DrachmaMfg/Diode-Ladder-VCF/VCF/Tayda Quick Order.csv

sku | qty
A-2281 | 10
A-2200 | 10
A-2307 | 10
A-2772 | 10
A-2290 | 10
A-2279 | 10
A-2248 | 10
A-2630 | 10
A-1531 | 5
A-4008 | 10
A-3290 | 2
A-4534 | 2
A-157 | 12
A-1138 | 2
A-2563 | 4
A-5591 | 5
A-5292 | 1
A-5776 | 1
A-1303 | 1
A-1305 | 1
A-2810 | 5
A-5582 | 1
A-2939 | 1
