DrachmaMfg/Diode-Ladder-VCF/VCF/Schematic.pdf

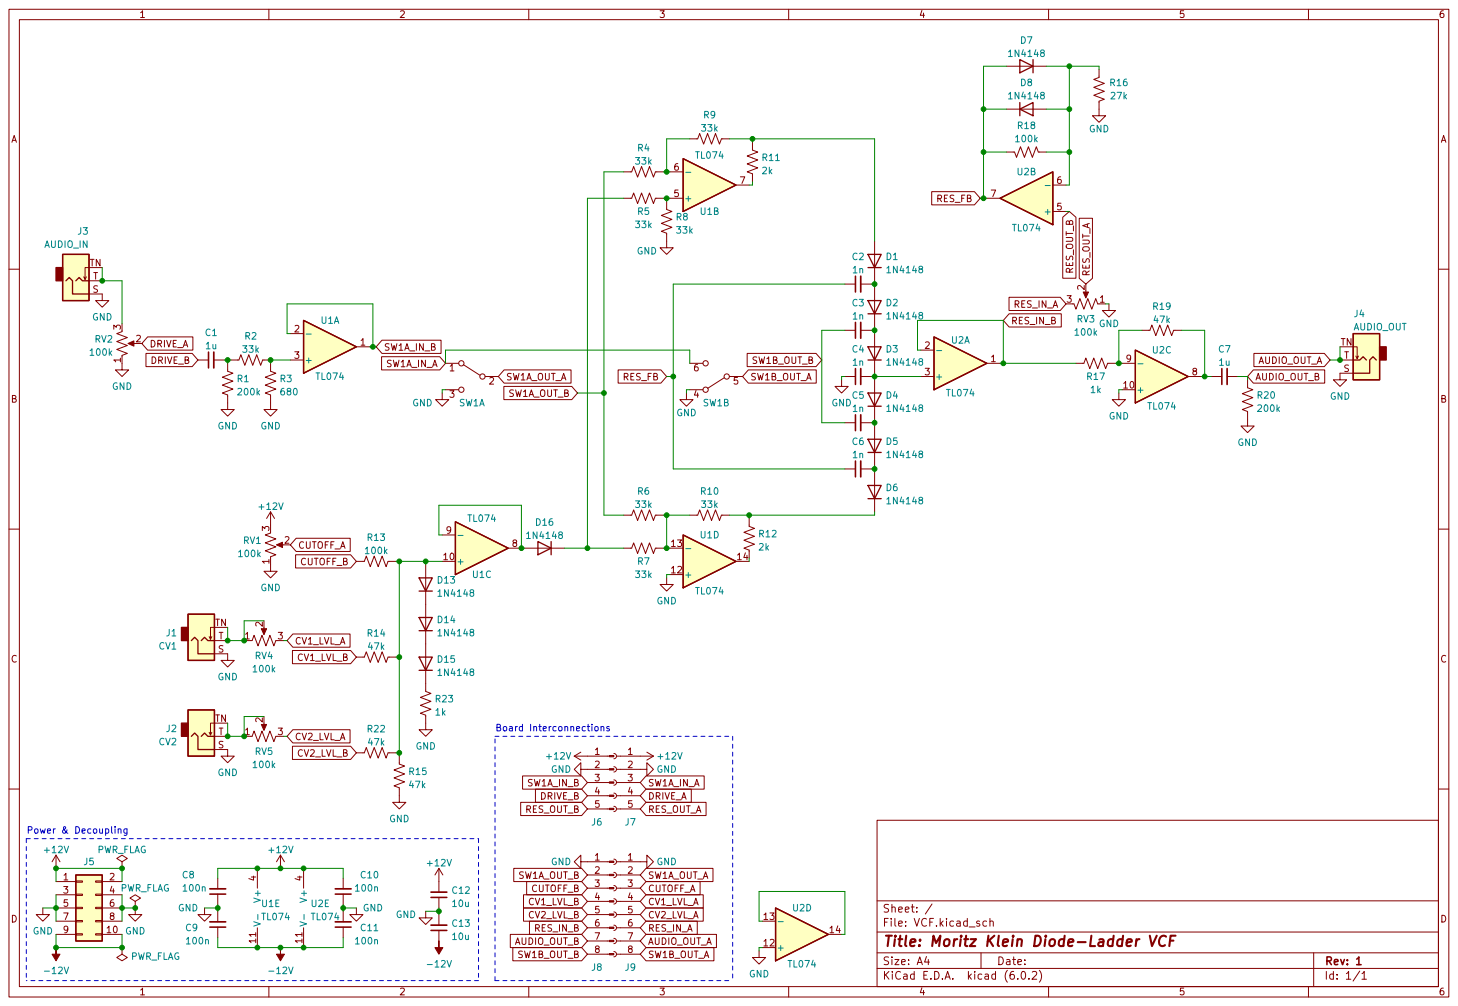
[picture p1: page 1]

File: VCF.kicad_sch Sheet: /
Id: 1/1 Title: Moritz Klein Diode-Ladder VCF
