DrachmaMfg/Diode-Ladder-VCF/VCF/KiCad Files/VCF.kicad_pcb

## KiCad design VCF/KiCad Files/VCF.kicad_pcb (2023-01-26)

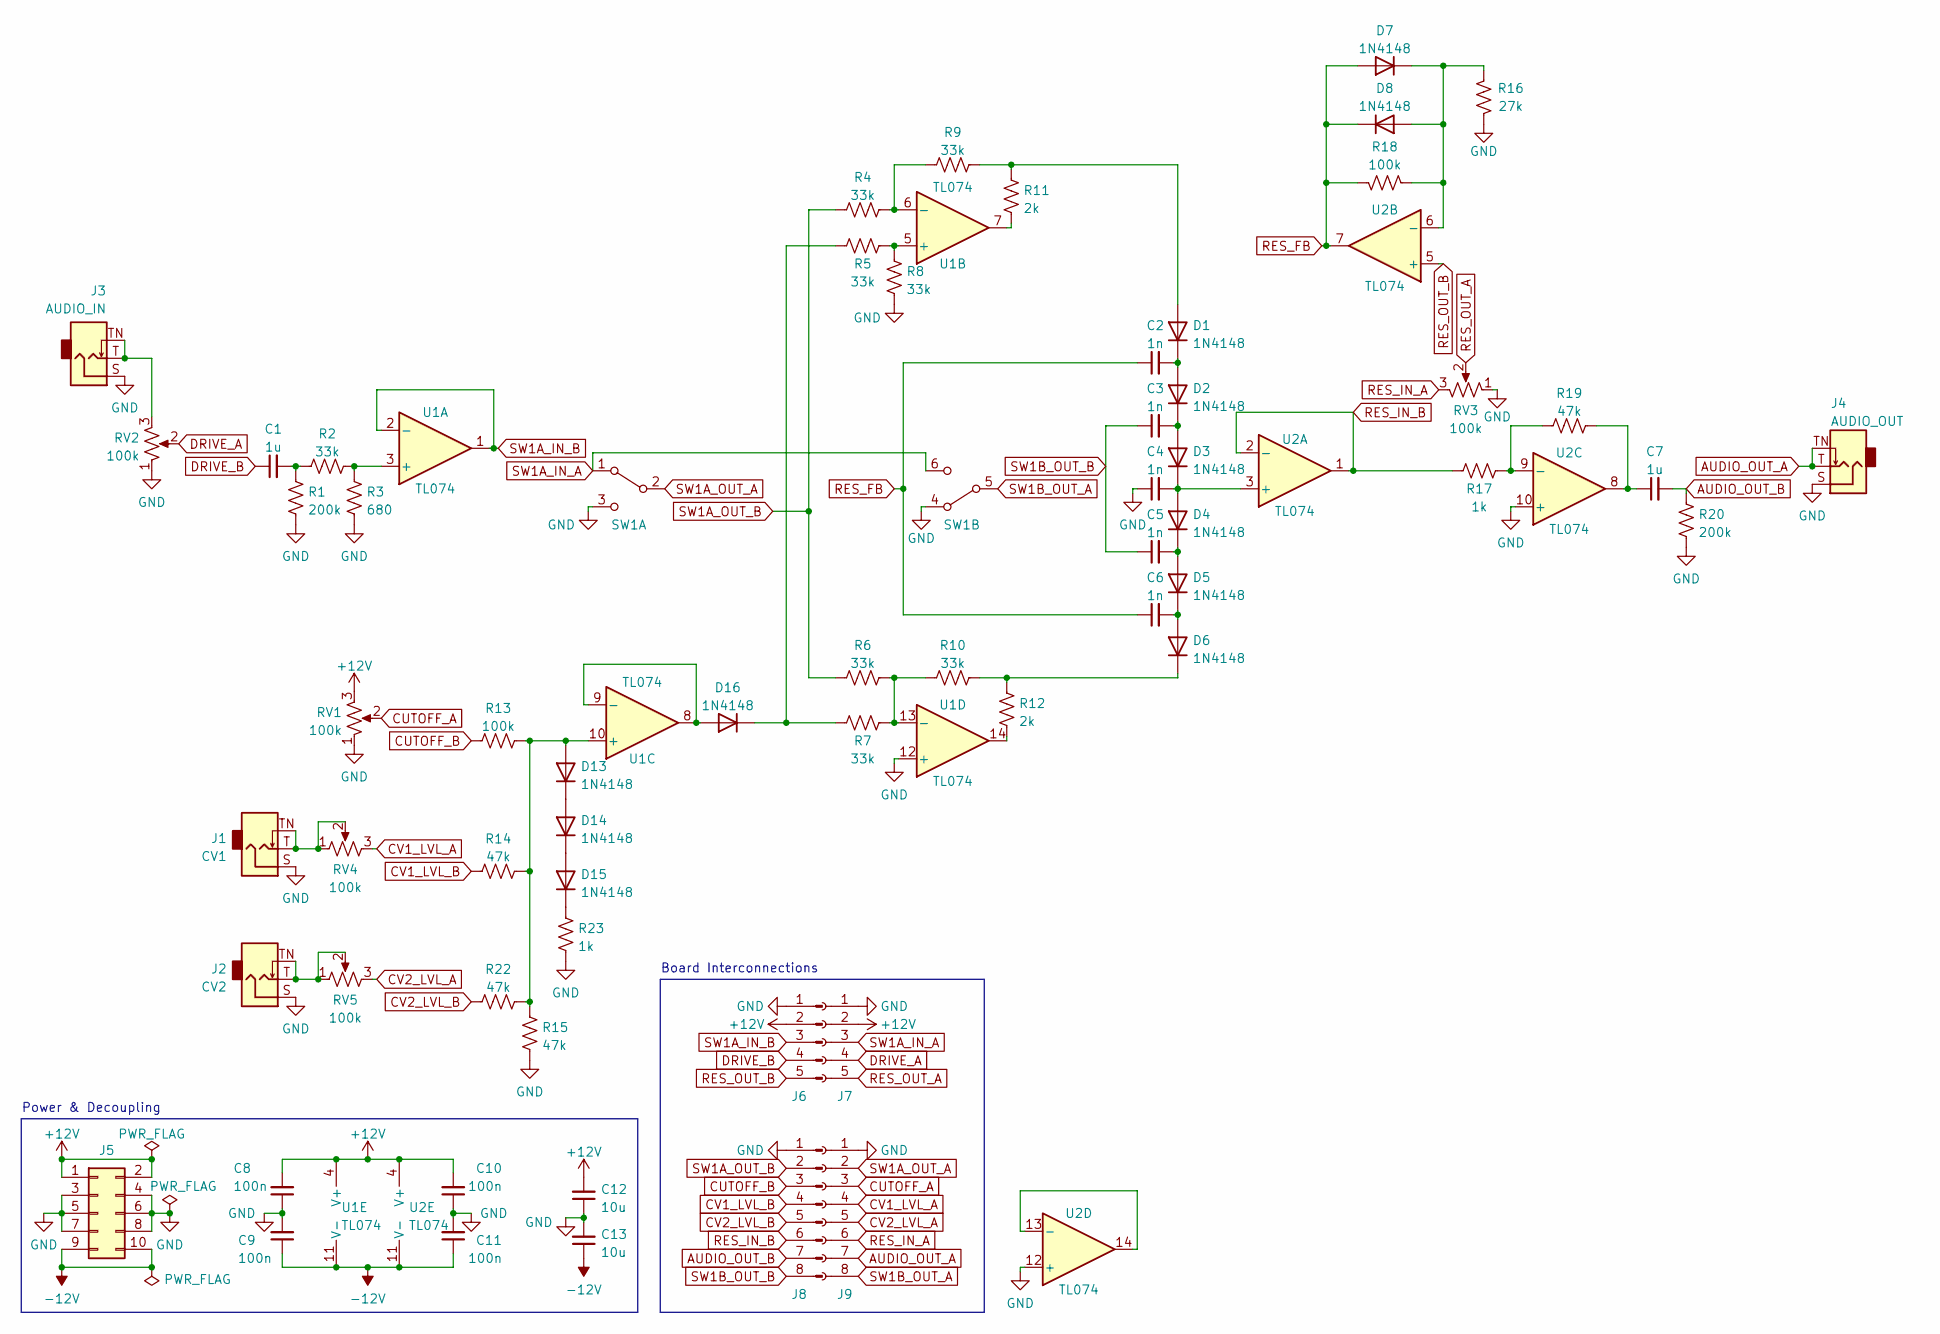
[picture p2: schematic VCF.kicad_sch, Moritz Klein Diode-Ladder VCF]

Parts:
C1, C7: 1u; C_Rect_L7.2mm_W3.5mm_P5.00mm_FKS2_FKP2_MKS2_MKP2
C2, C3, C4, C5, C6: 1n; C_Rect_L7.2mm_W2.5mm_P5.00mm_FKS2_FKP2_MKS2_MKP2
C8, C9, C10, C11: 100n; C_Disc_D3.8mm_W2.6mm_P2.50mm
C12, C13: 10u; CP_Radial_D5.0mm_P2.00mm
D1, D2, D3, D4, D5, D6, D7, D8, D13, D14, D15, D16: 1N4148; D_DO-35_SOD27_P7.62mm_Horizontal
J1: CV1; Jack_3.5mm_QingPu_WQP-PJ398SM_Vertical_CircularHoles_Compact
J2: CV2; Jack_3.5mm_QingPu_WQP-PJ398SM_Vertical_CircularHoles_Compact
J3: AUDIO_IN; Jack_3.5mm_QingPu_WQP-PJ398SM_Vertical_CircularHoles_Compact
J4: AUDIO_OUT; Jack_3.5mm_QingPu_WQP-PJ398SM_Vertical_CircularHoles_Compact
J5: Conn_02x05_Odd_Even; PinHeader_2x05_P2.54mm_Vertical
J6: Conn_01x05_Male; PinHeader_1x05_P2.54mm_Vertical
J7: Conn_01x05_Female; PinSocket_1x05_P2.54mm_Vertical
J8: Conn_01x08_Male; PinHeader_1x08_P2.54mm_Vertical
J9: Conn_01x08_Female; PinSocket_1x08_P2.54mm_Vertical
R1, R20: 200k; R_Axial_DIN0207_L6.3mm_D2.5mm_P7.62mm_Horizontal
R2, R4, R5, R6, R7, R8, R9, R10: 33k; R_Axial_DIN0207_L6.3mm_D2.5mm_P7.62mm_Horizontal
R3: 680; R_Axial_DIN0207_L6.3mm_D2.5mm_P7.62mm_Horizontal
R11, R12: 2k; R_Axial_DIN0207_L6.3mm_D2.5mm_P7.62mm_Horizontal
R13, R18: 100k; R_Axial_DIN0207_L6.3mm_D2.5mm_P7.62mm_Horizontal
R14, R15, R19, R22: 47k; R_Axial_DIN0207_L6.3mm_D2.5mm_P7.62mm_Horizontal
R16: 27k; R_Axial_DIN0207_L6.3mm_D2.5mm_P7.62mm_Horizontal
R17, R23: 1k; R_Axial_DIN0207_L6.3mm_D2.5mm_P7.62mm_Horizontal
RV1, RV2, RV3, RV4, RV5: 100k; Potentiometer_Alpha_Metal
SW1: SW_DPDT_x2; SW_DPDT_2MD1T2B1M1QES
U1, U2: TL074; DIP-14_W7.62mm

Connections:
+12V: C8.2, C10.2, C12.2, J5.1, J5.2, J6.2, J7.2, RV1.3, U1.4 (V+), U2.4 (V+)
-12V: C9.1, C11.1, C13.1, J5.9, J5.10, U1.11 (V-), U2.11 (V-)
AUDIO_OUT_A: J4.T, J4.TN, J9.7
AUDIO_OUT_B: C7.2, J8.7, R20.2
CUTOFF_A: J9.3, RV1.2
CUTOFF_B: J8.3, R13.1
CV1_LVL_A: J9.4, RV4.3
CV1_LVL_B: J8.4, R14.1
CV2_LVL_A: J9.5, RV5.3
CV2_LVL_B: J8.5, R22.1
DRIVE_A: J7.4, RV2.2
DRIVE_B: C1.1, J6.4
GND: C4.1, C8.1, C9.2, C10.1, C11.2, C12.1, C13.2, J1.S, J2.S, J3.S, J4.S, J5.3, J5.4, J5.5, J5.6, J5.7, J5.8, J6.1, J7.1, J8.1, J9.1, R1.1, R3.1, R8.1, R15.1, R16.1, R20.1, R23.1, RV1.1, RV2.1, RV3.1, SW1.3 (C), SW1.4 (A), U1.12 (+), U2.10 (+), U2.12 (+)
unnamed: C1.2, R1.2, R2.1
unnamed: C2.2, D1.1 (K), D2.2 (A)
unnamed: C3.2, D2.1 (K), D3.2 (A)
unnamed: C4.2, D3.1 (K), D4.2 (A), U2.3 (+)
unnamed: C5.2, D4.1 (K), D5.2 (A)
unnamed: C6.2, D5.1 (K), D6.2 (A)
unnamed: C7.1, R19.2, U2.8
unnamed: D1.2 (A), R9.2, R11.2
unnamed: D6.1 (K), R10.2, R12.2
unnamed: D7.1 (K), D8.2 (A), R16.2, R18.1, U2.6 (-)
unnamed: D13.1 (K), D14.2 (A)
unnamed: D13.2 (A), R13.2, R14.2, R15.2, R22.2, U1.10 (+)
unnamed: D14.1 (K), D15.2 (A)
unnamed: D15.1 (K), R23.2
unnamed: D16.1 (K), R5.1, R7.1
unnamed: D16.2 (A), U1.8, U1.9 (-)
unnamed: J1.T, J1.TN, RV4.1, RV4.2
unnamed: J2.T, J2.TN, RV5.1, RV5.2
unnamed: J3.T, J3.TN, RV2.3
unnamed: R2.2, R3.2, U1.3 (+)
unnamed: R4.2, R9.1, U1.6 (-)
unnamed: R5.2, R8.2, U1.5 (+)
unnamed: R6.2, R7.2, R10.1, U1.13 (-)
unnamed: R11.1, U1.7
unnamed: R12.1, U1.14
unnamed: R17.2, R19.1, U2.9 (-)
unnamed: U2.13 (-), U2.14
RES_FB: C2.1, C6.1, D7.2 (A), D8.1 (K), R18.2, U2.7
RES_IN_A: J9.6, RV3.3
RES_IN_B: J8.6, R17.1, U2.1, U2.2 (-)
RES_OUT_A: J7.5, RV3.2
RES_OUT_B: J6.5, U2.5 (+)
SW1A_IN_A: J7.3, SW1.1 (A), SW1.6 (C)
SW1A_IN_B: J6.3, U1.1, U1.2 (-)
SW1A_OUT_A: J9.2, SW1.2 (B)
SW1A_OUT_B: J8.2, R4.1, R6.1
SW1B_OUT_A: J9.8, SW1.5 (B)
SW1B_OUT_B: C3.1, C5.1, J8.8

Notes on the sheet:
Board Interconnections
Power & Decoupling

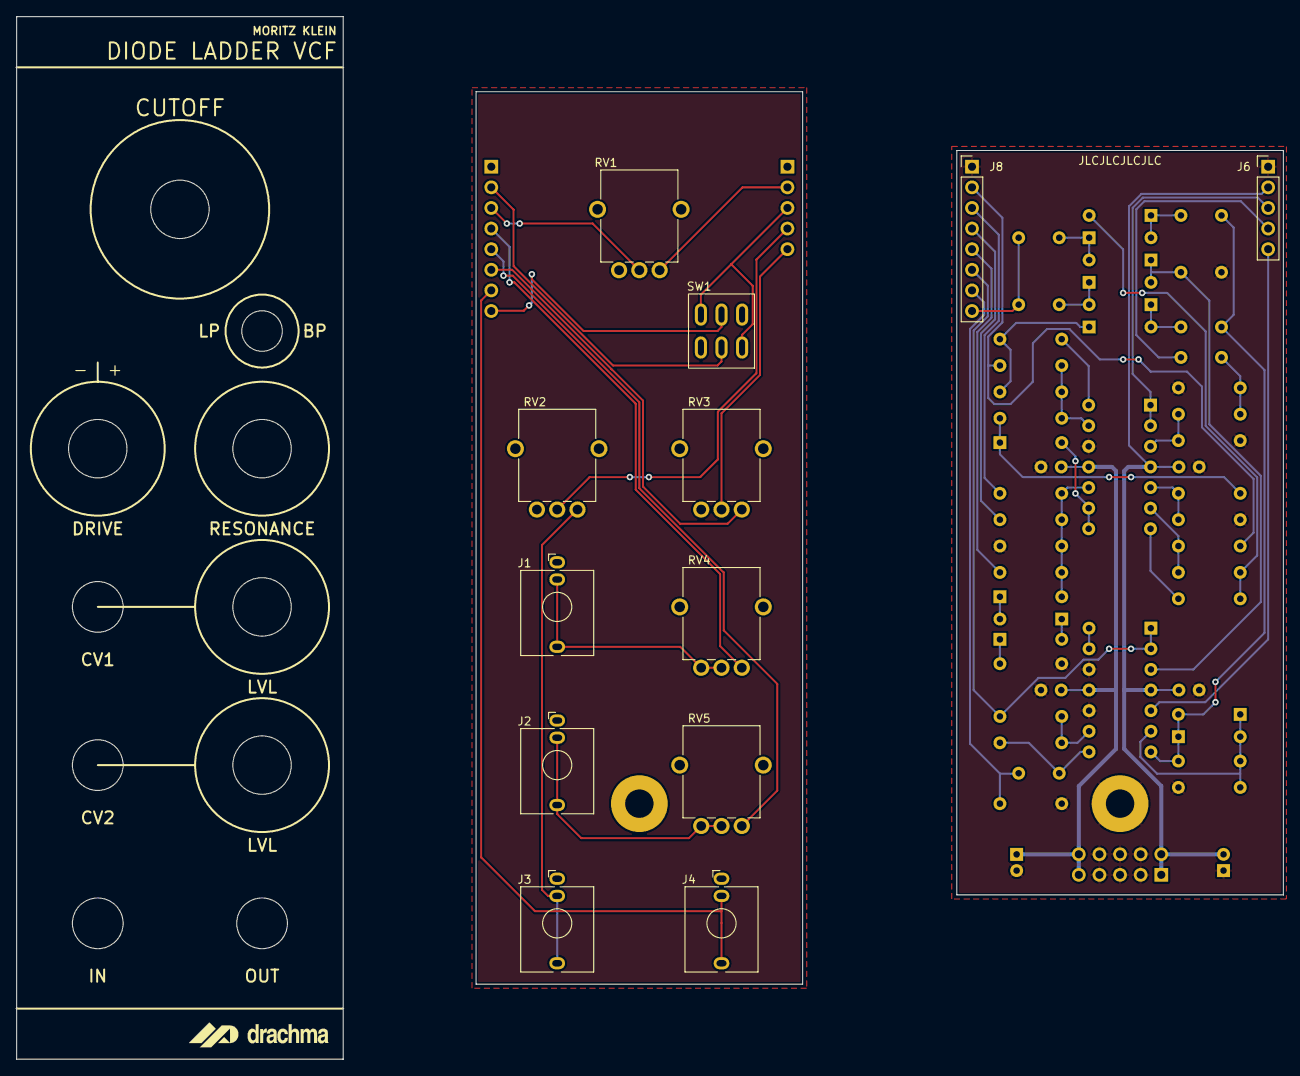
[picture p3: board VCF.kicad_pcb from above]

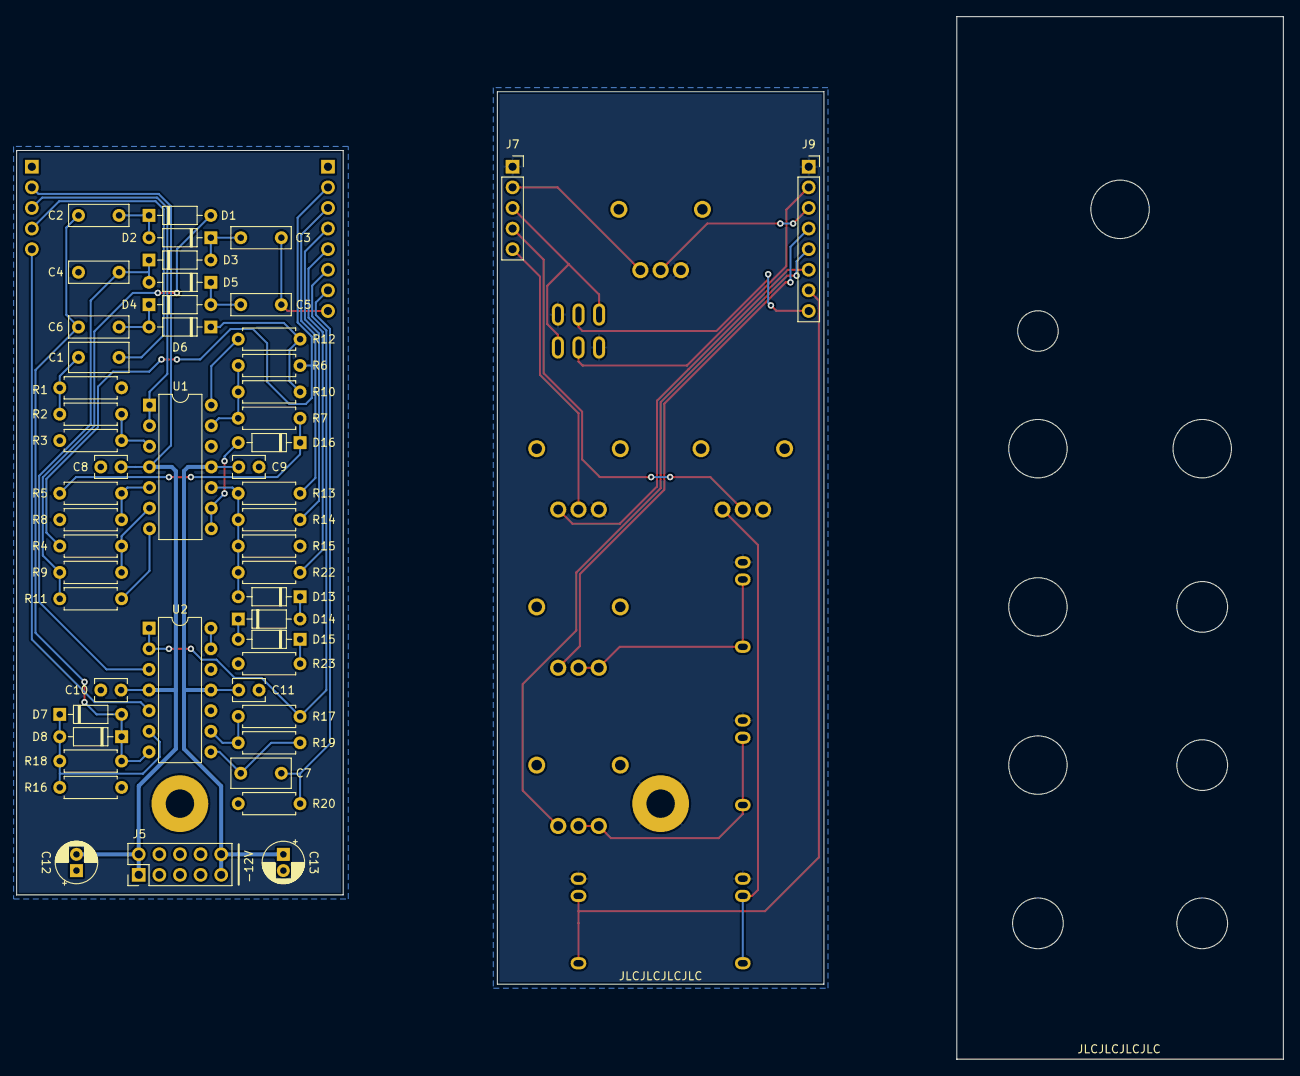
[picture p4: board VCF.kicad_pcb from below]

Board: 2 copper layers, 40.2 x 91.8 mm, 65 parts (52 on the bottom side), 51 nets.

Other parts of the board:
Ref**: Val**; logo_drachma_full_final_for_PCB
