DrachmaMfg/Diode-Ladder-VCF/(commit log)

2023-01-21 Added KiCad files
    [VCF.kicad_pcb, VCF.kicad_sch]
2023-01-22 Updated PCBs
    [VCF.kicad_pcb, VCF.kicad_sch]
2023-01-22 Updated directory organization
    [VCF.kicad_pcb, VCF.kicad_sch]
2023-01-22 Added board Gerber files
    [VCF.kicad_pcb]
2023-01-22 Corrected PCB
    [VCF.kicad_pcb, VCF.kicad_sch]
2023-01-22 Added gerber files
    [VCF.kicad_pcb]
2023-01-22 Cleaned up schematic
    [VCF.kicad_pcb, VCF.kicad_sch]
2023-01-22 Added PDF schematic
    [VCF.kicad_pcb, VCF.kicad_sch]
2023-01-23 Added BOM
    [BOM.xlsx, VCF.kicad_pcb, VCF.kicad_sch]
2023-01-23 Create Tayda Quick Order.csv
    [Tayda Quick Order.csv]
2023-01-23 Updated panel
    [Tayda Quick Order.csv, VCF.kicad_pcb]
2023-01-24 Corrected footprints
    [BOM.xlsx, Tayda Quick Order.csv, VCF.kicad_pcb, VCF.kicad_sch]
2023-01-24 Update Tayda Quick Order.csv
    [Tayda Quick Order.csv]
2023-01-24 Added PDF BOM
    [BOM.xlsx]
2023-01-24 Updated silkscreens
    [VCF.kicad_pcb]
